strnk/skippycopter/firmware/Dependencies.md

# Dependencies

Required depencies to properly program the platform:

- openocd (>= 0.9)
- libftdi (>=1.2)

## Building the dependencies
### libftdi
	sudo apt-get install build-essential git-core cmake doxygen libusb-1.0.0-dev libconfuse-dev swig python-dev libboost-all-dev

	git clone git://developer.intra2net.com/libftdi
	cd libftdi
	mkdir build
	cd build
	cmake  -DCMAKE_INSTALL_PREFIX="/usr" ../
	make
	sudo make install

### openocd
First, install the dependencies and bootstrap the compilation directory:

	sudo apt-get install git make libtool pkg-config autoconf automake texinfo

	git clone https://github.com/ntfreak/openocd.git
	cd openocd
	./bootstrap
	./configure --enable-usb_blaster_libftdi

Then, apply the *avr8.patch* patch from the firmware/openocd directory and run the compilation:

	git apply --stat ~/skippycopter/firmware/openocd/avr8.patch
	make
	sudo make install

Finally, apply the patch adding the Altera USB blaster UDEV rule and copy the rule file to the UDEV rules directory:
	
	git apply --stat ~/skippycopter/firmware/openocd/usbblaster.patch
	sudo cp contrib/99-openocd.rules /etc/udev/rules.d/

### libopencm3
Install the *arm-none-eabi* cross-compilation toolchain (available in Debian repos). Do **NOT** install the *arm-linux-gnueabi*, which is not suitable for bare-metal targets.

	sudo apt-get install gcc-arm-none-eabi libnewlib-arm-none-eabi

Clone the libopencm3 and compile it:

	git clone git://github.com/libopencm3/libopencm3.git
	cd libopencm3
	make
	sudo make install
