strnk/skippycopter/(threads)

Thread 1 (2015-05-27):

RX3 level not translated

strnk, 2015-05-27:
The voltage divider from 5V to 3.3V on RX3 (TX from telemetry) is reversed and does not translate the UART signal level.

strnk, 2015-05-28:
PC11 is 5V tolerant, so there is no need for the voltage divider anyway.

Closed 2015-05-28.

Thread 2 (2015-05-27):

Sensor I2C unstable above 100kHz

strnk, 2015-05-27:
The sensor I2C is unreliable in fast mode (FAST=1 DUTY=1) on the STM32 at 336kHz, maybe because of the 4K7 pull-up value which is too high.

The safe point is around 100kHz in standard mode.

strnk, 2015-05-28:
R12 and R13 values change to 1K5 fixes the problem, 400kHz and upward is stable.

Closed 2015-05-28.

Thread 3 (2015-05-27):

V_BATT LED unapplicable

strnk, 2015-05-27:
Assuming a 2.6V forward drop V_F of LED1 and V_BATT=18V, the dissipated power of R2 is around 15.4V*20mA = 308mW which is too much for a 1206 resistor (~250mW).

Thread 4 (2015-05-27):

Powerboard output should be 5V

strnk, 2015-05-27:
The motherboard needs 5V for the SRF-04, the MAVLink telemetry board and a possible on-board camera.

Thread 5 (2015-07-15):

12V power rail required for video video transmitter

strnk, 2015-07-15:
Most 2.4GHz / 5.8GHz needs a 12V power rail to work properly, it should be added on the powerboard.
