strnk/skippycopter/release-to-manufacturing/pcb/motherboard_v1a_top.pdf

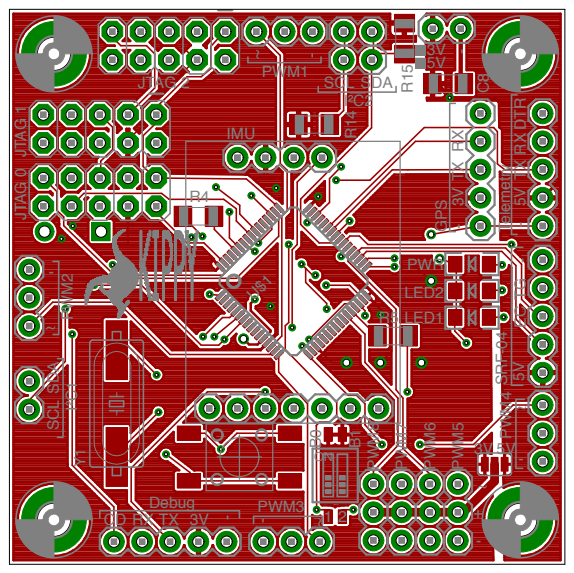
[picture p1: page 1]
SCL SDA I²C2; - PWM1; JTAG 2; JTAG 0 JTAG 1; PWM2; SCL SDA; I²C1; PWM3 -; PWM4; PWM8; PWM7; PWM6; PWM5 -; LED1; LED2; PWR; - 5V TG EC SRF⁻04; Telemetry; GPS; IMU

- 5V TX RX DTR

Debug
