strnk/skippycopter/release-to-manufacturing/pcb/motherboard_v1a_bottom.pdf

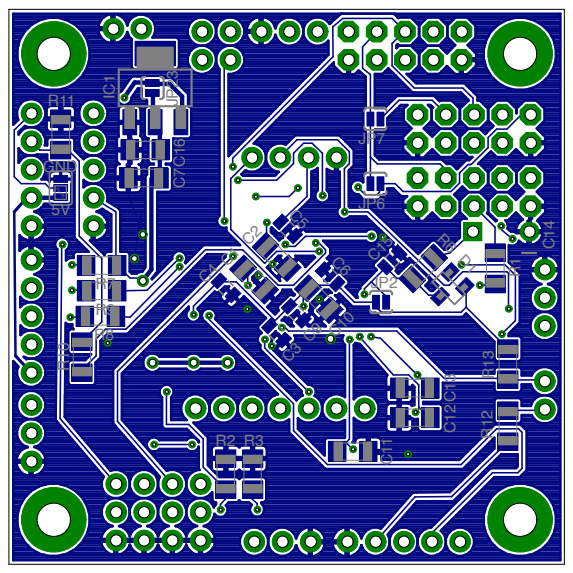
[picture p2: page 1]
