strnk/skippycopter/schematics/powerboard/powerboard_v1.brd

## EAGLE design schematics/powerboard/powerboard_v1.brd (2015-02-19, an earlier design)

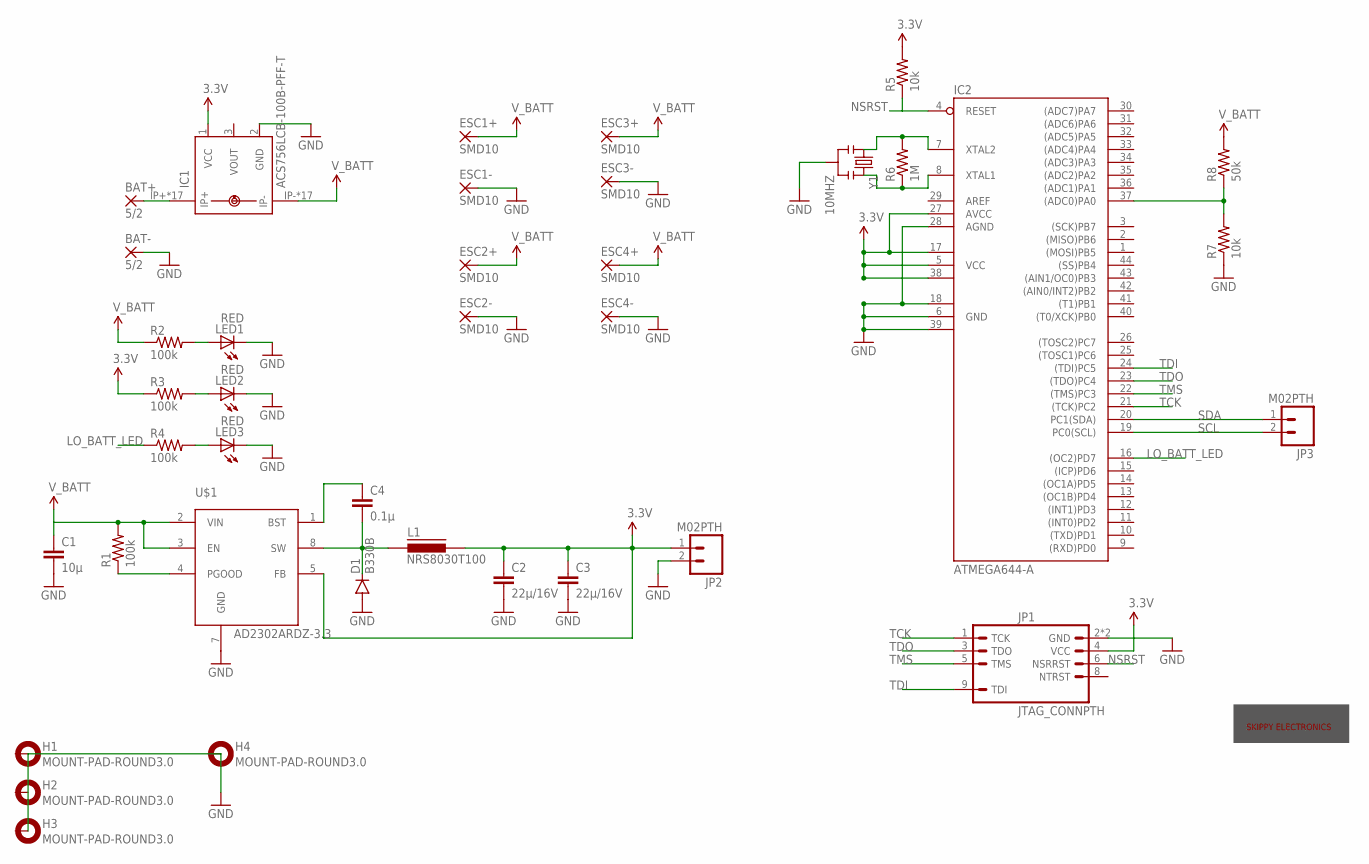
[picture p3: schematic powerboard_v1.sch]

Parts:
BAT+: 5/2
BAT-: 5/2
C1: 10µ; 1206
C2, C3: 22µ/16V; 1206
C4: 0.1µ; 1206
D1: B330B; SMB-DIODE
ESC1+, ESC1-, ESC2+, ESC2-, ESC3+, ESC3-, ESC4+, ESC4-: SMD10; SMD5.08-10.16
H1, H2, H3, H4: MOUNT-PAD-ROUND3.0; 3,0-PAD
IC1: ACS756LCB-100B-PFF-T; CB-PFF
IC2: ATMEGA644-A; TQFP44
JP1: JTAG_CONNPTH; AVR_ICSP
JP2, JP3: M02PTH; 1X02
L1: NRS8030T100; NRS8030
LED1, LED2, LED3: RED; LED_1206
PLC1: SKIPPY-PLC-10MMPLC; SKIPPY-PLC-10MM
R1, R2, R3, R4: 100k; 1206
R5, R7: 10k; 1206
R6: 1M; 1206
R8: 50k; 1206
U$1: AD2302ARDZ-3.3; SO8
Y1: 10MHZ; RESONATOR-SMD

Connections:
3.3V: C2.1, C3.1, IC1.1 (VCC), IC2.5 (VCC), IC2.17 (VCC1), IC2.27 (AVCC), IC2.38 (VCC2), JP1.4 (VCC), JP2.1, L1.P$2 (2), R3.1, R5.2, U$1.5 (FB)
GND: BAT-.P$1, C1.2, C2.2, C3.2, D1.A, ESC1-.P$1, ESC1-.P$2, ESC2-.P$1, ESC2-.P$2, ESC3-.P$1, ESC3-.P$2, ESC4-.P$1, ESC4-.P$2, IC1.2 (GND), IC2.6 (GND), IC2.18 (GND1), IC2.28 (AGND), IC2.39 (GND2), JP1.2 (GND), JP1.10 (GND), JP2.2, LED1.C, LED2.C, LED3.C, R7.1, U$1.7 (GND), Y1.2
I_VOUT: IC1.3 (VOUT), IC2.35 ((ADC2)PA2)
LO_BATT_LED: IC2.16 ((OC2)PD7), R4.1
unnamed: BAT+.P$1, IC1.IP+, IC1.IP+@2 (IP+), IC1.IP+@3 (IP+), IC1.IP+@4 (IP+), IC1.IP+@5 (IP+), IC1.IP+@6 (IP+), IC1.IP+@7 (IP+), IC1.IP+@8 (IP+), IC1.IP+@9 (IP+), IC1.IP+@10 (IP+), IC1.IP+@11 (IP+), IC1.IP+@12 (IP+), IC1.IP+@13 (IP+), IC1.IP+@14 (IP+), IC1.IP+@15 (IP+), IC1.IP+@16 (IP+), IC1.IP+@17 (IP+)
unnamed: C4.2, D1.C, L1.P$1 (1), U$1.8 (SW)
unnamed: R1.1, U$1.4 (PGOOD)
unnamed: LED1.A, R2.2
unnamed: C4.1, U$1.1 (BST)
unnamed: LED2.A, R3.2
unnamed: LED3.A, R4.2
unnamed: IC2.7 (XTAL2), R6.2, Y1.1
unnamed: IC2.8 (XTAL1), R6.1, Y1.3
unnamed: IC2.37 ((ADC0)PA0), R7.2, R8.1
NSRST: IC2.4 (RESET), JP1.6 (NSRRST), R5.1
SCL: IC2.19 (PC0(SCL)), JP3.2
SDA: IC2.20 (PC1(SDA)), JP3.1
TCK: IC2.21 ((TCK)PC2), JP1.1 (TCK)
TDI: IC2.24 ((TDI)PC5), JP1.9 (TDI)
TDO: IC2.23 ((TDO)PC4), JP1.3 (TDO)
TMS: IC2.22 ((TMS)PC3), JP1.5 (TMS)
V_BATT: C1.1, ESC1+.P$1, ESC1+.P$2, ESC2+.P$1, ESC2+.P$2, ESC3+.P$1, ESC3+.P$2, ESC4+.P$1, ESC4+.P$2, IC1.IP-, IC1.IP-@2 (IP-), IC1.IP-@3 (IP-), IC1.IP-@4 (IP-), IC1.IP-@5 (IP-), IC1.IP-@6 (IP-), IC1.IP-@7 (IP-), IC1.IP-@8 (IP-), IC1.IP-@9 (IP-), IC1.IP-@10 (IP-), IC1.IP-@11 (IP-), IC1.IP-@12 (IP-), IC1.IP-@13 (IP-), IC1.IP-@14 (IP-), IC1.IP-@15 (IP-), IC1.IP-@16 (IP-), IC1.IP-@17 (IP-), R1.2, R2.1, R8.2, U$1.2 (VIN), U$1.3 (EN)

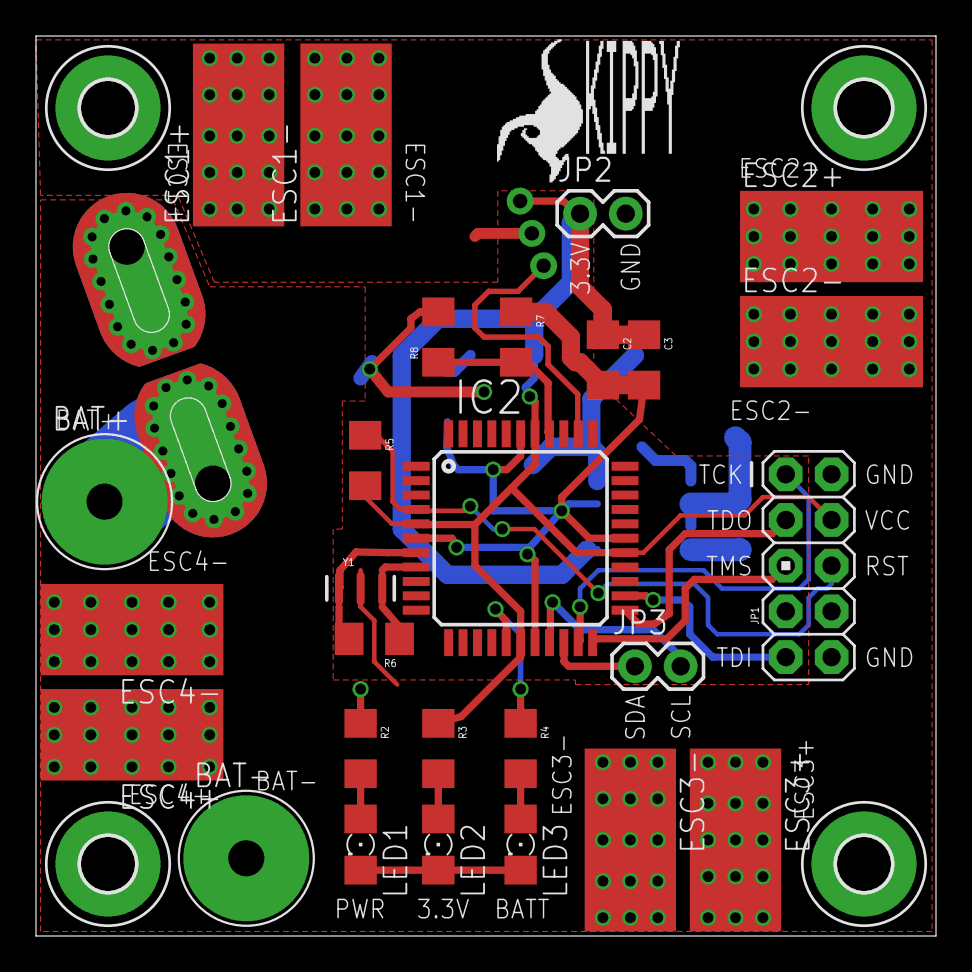
[picture p4: board powerboard_v1.brd from above]

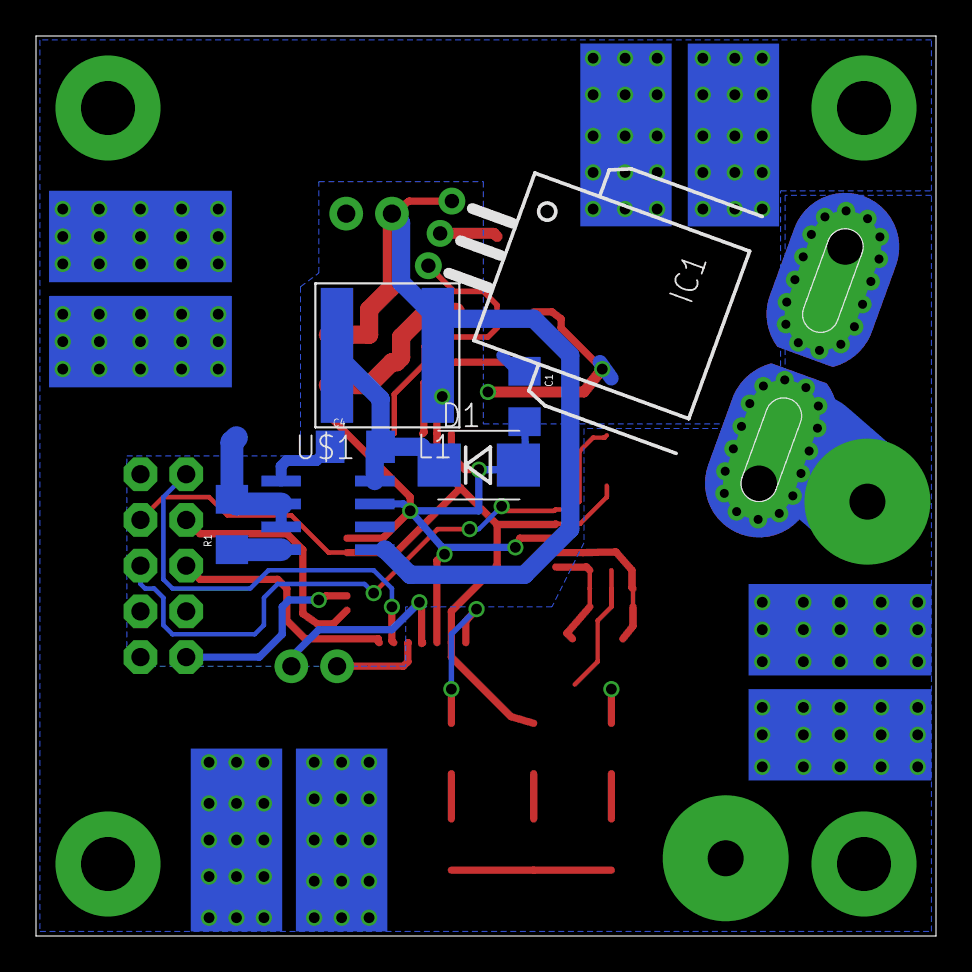
[picture p5: board powerboard_v1.brd from below]

Board: 2 copper layers, 50.0 x 50.0 mm, 39 parts (7 on the bottom side), 22 nets.

Other parts of the board:
U$2: SKIPPYTXT-PLC-10MM
