strnk/skippycopter/schematics/motherboard/motherboard_v1.brd

## EAGLE design schematics/motherboard/motherboard_v1.brd (2015-05-28)

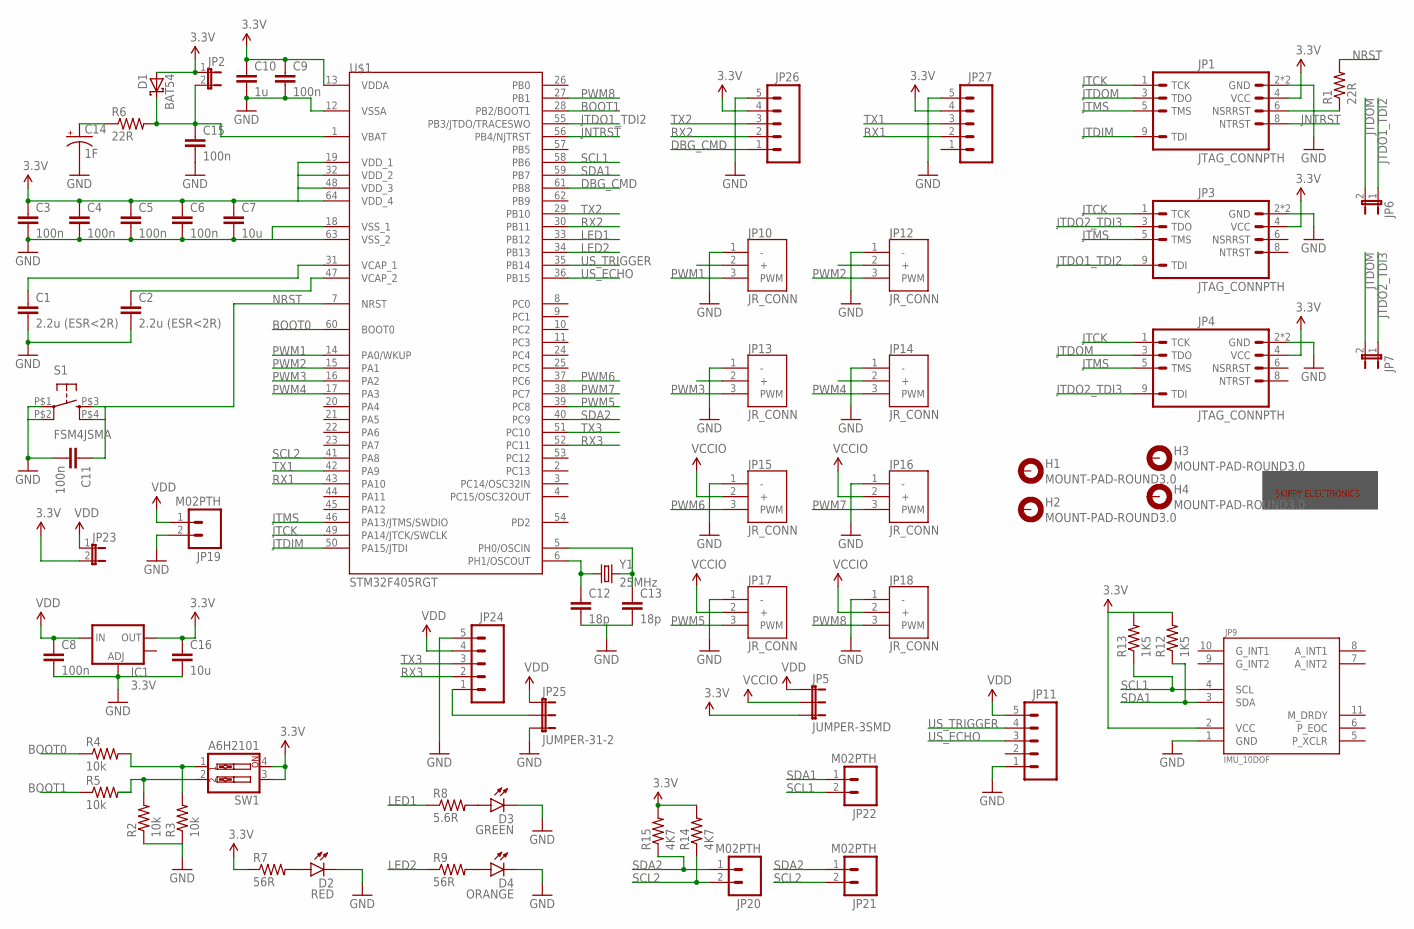
[picture p6: schematic motherboard_v1.sch]

Parts:
C1, C2: 2.2u (ESR<2R); 1206
C3, C4, C5, C6, C9, C15: 100n; 0805
C7, C16: 10u; 1206
C8, C11: 100n; 1206
C10: 1u; 1206
C12, C13: 18p; 1206
C14: 1F; CPOL-RADIAL-D165-P508
D1: BAT54; SOT23
D2: RED; LED-1206
D3: GREEN; LED-1206
D4: ORANGE; LED-1206
H1, H2, H3, H4: MOUNT-PAD-ROUND3.0; 3,0-PAD
IC1: 3.3V; SOT223
JP1, JP3, JP4: JTAG_CONNPTH; AVR_ICSP
JP2, JP6, JP7, JP23: JUMPER-2SMD-NO; SJ_2S-NO
JP5: JUMPER-3SMD; SJ_3
JP9: IMU_10DOF
JP10, JP12, JP13, JP14, JP15, JP16, JP17, JP18: JR_CONN; 1X03
JP11, JP24, JP26, JP27: M05PTH; 1X05
JP19, JP20, JP21, JP22: M02PTH; 1X02
JP25: JUMPER-31-2; SJ_3_PASTE1&2
R1, R6: 22R; 1206
R2, R3, R4, R5: 10k; 1206
R7, R9: 56R; 1206
R8: 5.6R; 1206
R12, R13: 1K5; 1206
R14, R15: 4K7; 1206
S1: FSM4JSMA; TYCO-FSM4JSMA
SW1: A6H2101; DIPSWITCH-02-50MIL
U$1: STM32F405RGT; LQFP-ST-64-2
U$2: SKIPPYTXT-PLC-10MM
Y1: 25MHz; HC49UP

Connections:
3.3V: C3.1, C4.1, C5.1, C6.1, C7.1, C9.1, C10.1, C16.1, D1.1 (A), IC1.2 (OUT), JP1.4 (VCC), JP2.1, JP3.4 (VCC), JP4.4 (VCC), JP5.3, JP9.2 (VCC), JP23.2, JP26.4, JP27.4, R7.1, R12.2, R13.2, R14.2, R15.2, SW1.3, SW1.4, U$1.13 (VDDA), U$1.19 (VDD_1), U$1.32 (VDD_2), U$1.48 (VDD_3), U$1.64 (VDD_4)
BOOT0: R4.1, U$1.60 (BOOT0)
BOOT1: R5.1, U$1.28 (PB2/BOOT1)
DBG_CMD: JP26.1, U$1.61 (PB8)
GND: C1.2, C2.2, C3.2, C4.2, C5.2, C6.2, C7.2, C8.2, C9.2, C10.2, C11.2, C12.2, C13.2, C14.2 (-), C15.2, C16.2, D2.C, D3.C, D4.C, IC1.1 (ADJ), JP1.2 (GND), JP1.10 (GND), JP3.2 (GND), JP3.10 (GND), JP4.2 (GND), JP4.10 (GND), JP9.1 (GND), JP10.1 (-), JP11.1, JP12.1 (-), JP13.1 (-), JP14.1 (-), JP15.1 (-), JP16.1 (-), JP17.1 (-), JP18.1 (-), JP19.2, JP24.5, JP25.3, JP26.5, JP27.5, R2.1, R3.1, S1.P$1 (1), S1.P$2 (2), U$1.12 (VSSA), U$1.18 (VSS_1), U$1.63 (VSS_2)
JNTRST: JP1.8 (NTRST), U$1.56 (PB4/NJTRST)
JTCK: JP1.1 (TCK), JP3.1 (TCK), JP4.1 (TCK), U$1.49 (PA14/JTCK/SWCLK)
JTDIM: JP1.9 (TDI), U$1.50 (PA15/JTDI)
JTDO1_TDI2: JP3.9 (TDI), JP6.1, U$1.55 (PB3/JTDO/TRACESWO)
JTDO2_TDI3: JP3.3 (TDO), JP4.9 (TDI), JP7.1
JTDOM: JP1.3 (TDO), JP4.3 (TDO), JP6.2, JP7.2
JTMS: JP1.5 (TMS), JP3.5 (TMS), JP4.5 (TMS), U$1.46 (PA13/JTMS/SWDIO)
LED1: R8.1, U$1.33 (PB12)
LED2: R9.1, U$1.34 (PB13)
unnamed: C1.1, U$1.31 (VCAP_1)
unnamed: C2.1, U$1.47 (VCAP_2)
unnamed: C12.1, U$1.6 (PH1/OSCOUT), Y1.1
unnamed: JP1.6 (NSRRST), R1.1
unnamed: C13.1, U$1.5 (PH0/OSCIN), Y1.2
unnamed: R3.2, R4.2, SW1.1
unnamed: R2.2, R5.2, SW1.2
unnamed: D2.A, R7.2
unnamed: C14.1 (+), R6.1
unnamed: C15.1, D1.3 (C), JP2.2, R6.2, U$1.1 (VBAT)
unnamed: D3.A, R8.2
unnamed: JP24.1, JP25.2
unnamed: D4.A, R9.2
NRST: C11.1, R1.2, S1.P$3 (3), S1.P$4 (4), U$1.7 (NRST)
PWM1: JP10.3 (PWM), U$1.14 (PA0/WKUP)
PWM2: JP12.3 (PWM), U$1.15 (PA1)
PWM3: JP13.3 (PWM), U$1.16 (PA2)
PWM4: JP14.3 (PWM), U$1.17 (PA3)
PWM5: JP17.3 (PWM), U$1.39 (PC8)
PWM6: JP15.3 (PWM), U$1.37 (PC6)
PWM7: JP16.3 (PWM), U$1.38 (PC7)
PWM8: JP18.3 (PWM), U$1.27 (PB1)
RX1: JP27.2, U$1.43 (PA10)
RX2: JP26.2, U$1.30 (PB11)
RX3: JP24.2, U$1.52 (PC11)
SCL1: JP9.4 (SCL), JP22.2, R13.1, U$1.58 (PB6)
SCL2: JP20.2, JP21.2, R14.1, U$1.41 (PA8)
SDA1: JP9.3 (SDA), JP22.1, R12.1, U$1.59 (PB7)
SDA2: JP20.1, JP21.1, R15.1, U$1.40 (PC9)
TX1: JP27.3, U$1.42 (PA9)
TX2: JP26.3, U$1.29 (PB10)
TX3: JP24.3, U$1.51 (PC10)
US_ECHO: JP11.3, U$1.36 (PB15)
US_TRIGGER: JP11.4, U$1.35 (PB14)
VCCIO: JP5.2, JP15.2 (+), JP16.2 (+), JP17.2 (+), JP18.2 (+)
VDD: C8.1, IC1.3 (IN), JP5.1, JP11.5, JP19.1, JP23.1, JP24.4, JP25.1

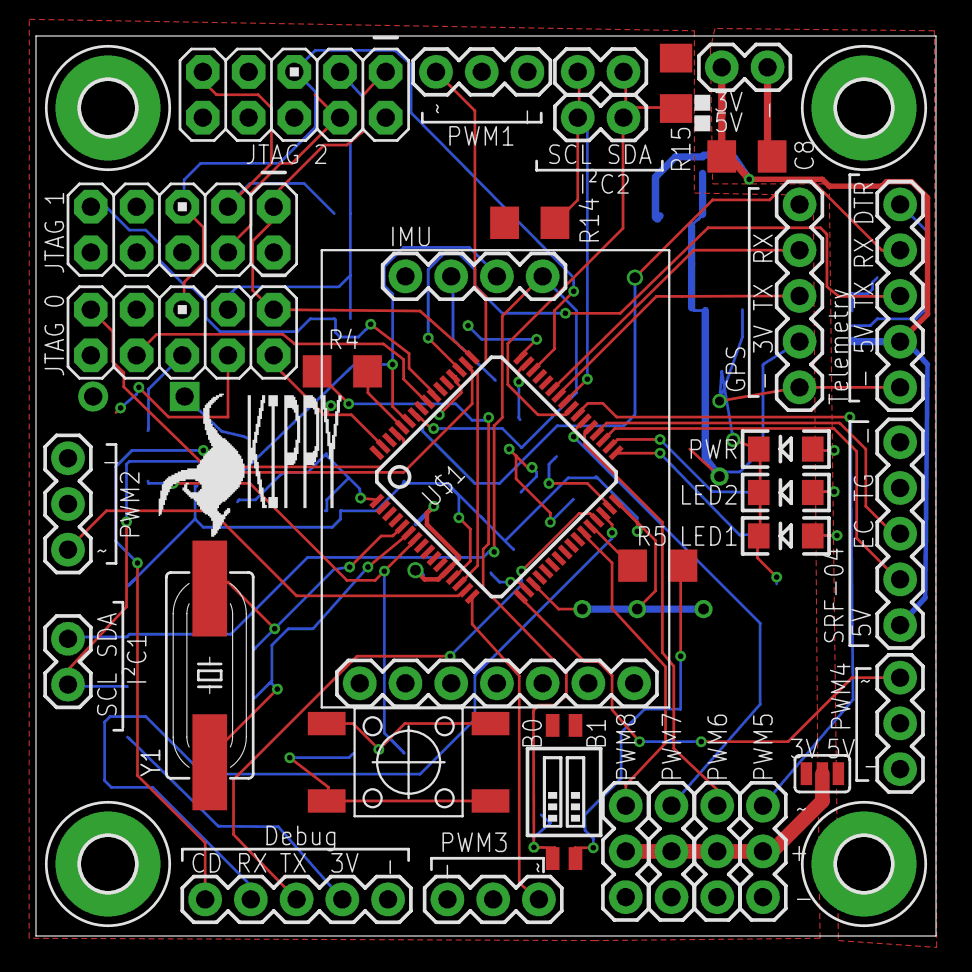
[picture p7: board motherboard_v1.brd from above]

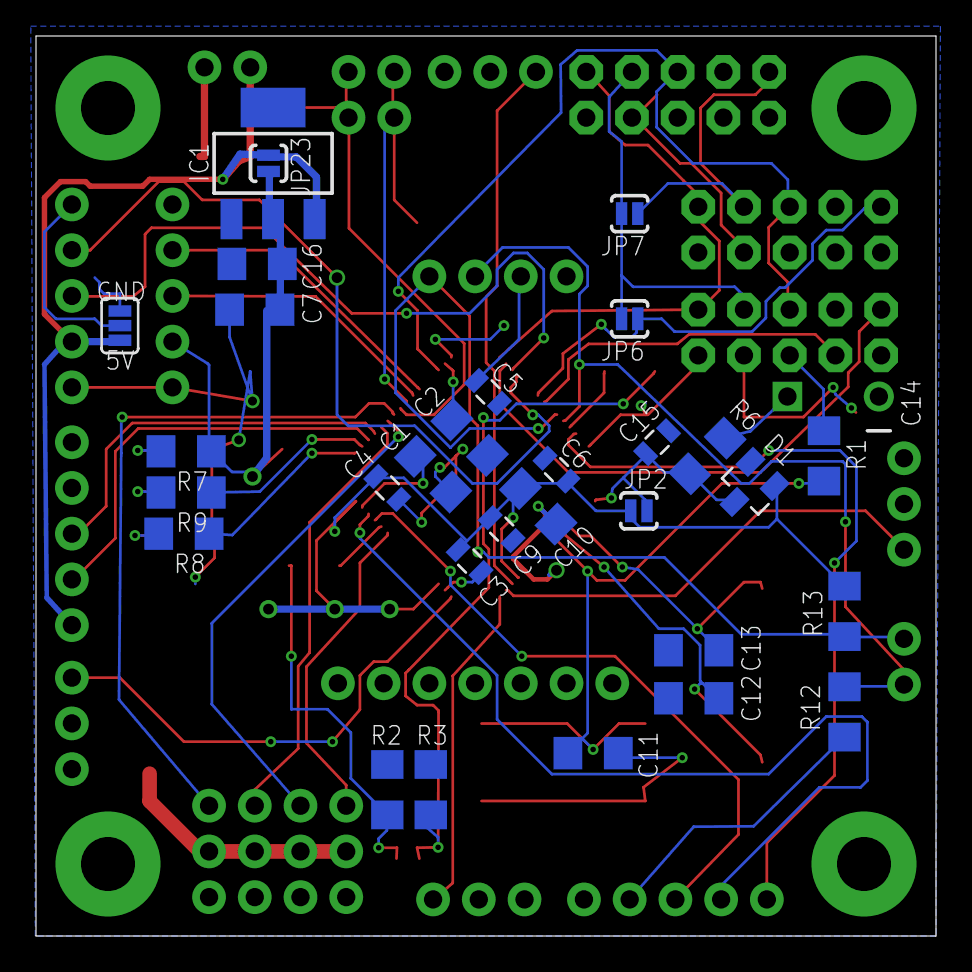
[picture p8: board motherboard_v1.brd from below]

Board: 2 copper layers, 50.0 x 50.0 mm, 69 parts (31 on the bottom side), 50 nets.
