strnk/skippycopter/firmware/motherboard/cli/functions/system.h

#ifndef CLI_FUNCTIONS_SYSTEM_H
#define CLI_FUNCTIONS_SYSTEM_H

#include <cli/cli.h>

#ifdef __cplusplus
extern "C" {
#endif

uint8_t cli_func_system_ping(int argc, char **argv);
uint8_t cli_func_system_power(int argc, char **argv);
uint8_t cli_func_system_flag_enable(int argc, char **argv);
uint8_t cli_func_system_flag_disable(int argc, char **argv);
uint8_t cli_func_system_ppm(int argc, char **argv);
uint8_t cli_func_system_radio(int argc, char **argv);

#ifdef __cplusplus
}
#endif

#endif // CLI_FUNCTIONS_SYSTEM_H
