strnk/skippycopter/(commit log)

2013-12-06 Battery docs
2013-12-06 ESC docs
2013-12-06 IMU docs
2013-12-21 SeeedStudio libraries and motherboard schematic draft
2013-12-21 New STM32F405RGT symbol in stm32 lib
2013-12-24 Quadricopter sizing excel sheet
    [CopterSizing.xlsx]
2014-01-07 Adding documentation for dual USB UART/FIFO FT2232
2015-02-07 Eagle lib update & logos
    [CopterSizing.xlsx]
2015-02-08 Reorganized libs, added DC/DC buck converter and power board
    [powerboard_v1.sch]
2015-02-08 Inductor lib and powerboard 5V rail
    [powerboard_v1.sch]
2015-02-09 Power board finalized
    [powerboard_v1.sch]
2015-02-09 Power board PCB placement
    [powerboard_v1.brd]
2015-02-11 New PCB for power board
    [powerboard_v1.0.brd, powerboard_v1.1.brd, powerboard_v1.sch]
2015-02-19 Lower resolution logo for Gerber export
2015-02-19 Powerboard PCB and schematics revisions a and b
    [powerboard_v1.1.brd, powerboard_v1.brd, powerboard_v1a.brd, powerboard_v1a.sch, powerboard_v1b.brd, powerboard_v1b.sch]
2015-02-19 Powerboard PCB rev 1b RTM Gerber export for Seeedstudio
2015-02-20 Seeedstudio Powerboard RTM rev 1b fix
2015-05-01 Motherboard schematic draft
    [motherboard_v1.sch]
2015-05-03 Motherboard reference design
    [motherboard_v1.sch]
2015-05-04 Library refactor and motherboard update
    [motherboard_v1.sch]
2015-05-04 Bluetooth debug module and external boards lib. Motherboard update
    [motherboard_v1.sch]
2015-05-05 Motherboard update and PCB draft
    [motherboard_v1.brd, motherboard_v1.sch]
2015-05-06 MB PCB update
    [motherboard_v1.brd, motherboard_v1.sch]
2015-05-07 Motherboard update with almost-ready routing
    [motherboard_v1.brd, motherboard_v1.sch]
2015-05-08 Motherboard v1 RTM
    [motherboard_v1.brd, motherboard_v1.sch]
2015-05-10 Powerboard test firmware
2015-05-10 OpenOCD scripts and global Makefile
    [erase-all.cfg, flash-all.cfg, shutdown.cfg, skippycopter-system.cfg, skippycopter.cfg]
2015-05-11 Motherboard printouts and boards documentation
2015-05-17 Chain test with STM32 discovery
    [flash-all.cfg, skippycopter-system.cfg, skippycopter.cfg]
2015-05-26 Rework of the openOCD scripts to support single card flashing and MB UART test with console support
    [erase-all.cfg, flash-motherboard.cfg, flash-powerboard.cfg, init.cfg, motherboard.cfg, powerboard.cfg, skippycopter.cfg]
2015-05-28 Fixes issues #1 and #2
    [motherboard_v1.brd, motherboard_v1.sch]
2015-05-28 Motherboard IMU test
2015-05-29 Removed old powerboard revs
    [powerboard_v1.brd, powerboard_v1a.brd, powerboard_v1a.sch, powerboard_v1b.brd, powerboard_v1b.sch]
2015-05-30 IMU compass example
2015-05-31 Motherboard firmware C++ rework
    [adxl345.cpp, adxl345.h, bmp085.cpp, bmp085.h, board_setup.h, hmc5883l.cpp, hmc5883l.h]
2015-05-31 I2C write fix and ADXL345 test
    [adxl345.cpp, adxl345.h, hmc5883l.cpp, i2c_device.cpp, imu.cpp, imu.h, main.cpp]
2015-05-31 Full IMU draft + temporal scheduler
2015-06-03 Skippy Monitor update with IMU plotting support
    [bluetooth.py, direct.py, interpreters.py, thread.py]
2015-06-03 Gyro register reading fix and 115200baud UART. IMU debug
    [common.h, l3g4200d.cpp, l3g4200d.h, main.cpp]
2015-06-08 L3G4200D reading problem fix
    [i2c_device.h, l3g4200d.cpp, l3g4200d.h]
2015-07-05 PWM peripheral + ESC arm
2015-07-05 Small fix. in the Sys. Scheduler debug log
    [sys_scheduler.cpp]
2015-07-06 CLI interface draft. CLI PWM support
2015-07-13 I2C stack and voltage/intensity monitor
2015-07-13 Powerboard flash fix
    [flash-powerboard.cfg]
2015-07-13 System bus support + powerboard V/I readings
2015-07-13 CLI flag support (fd/fe) and hardware madgwick implementation at 500Hz
2015-07-14 Raw attitude data over uart (fe/fd raw_attitude)
2015-07-14 Attitude now supported with AT messages from copter instead of raw sensors. Line edit on main window enabled, use ENTER or Send button to send lines over UART
2015-07-29 Added radio PPM decoder + RF test on one motor. Renamed system messages flags
2015-07-29 Added system messages debugger, cell voltage indicator and charge progressbar
